cdhooper/mx29f1615_programmer/photos/2021_08_17_mx29f1615_programmer_rev6.jpg

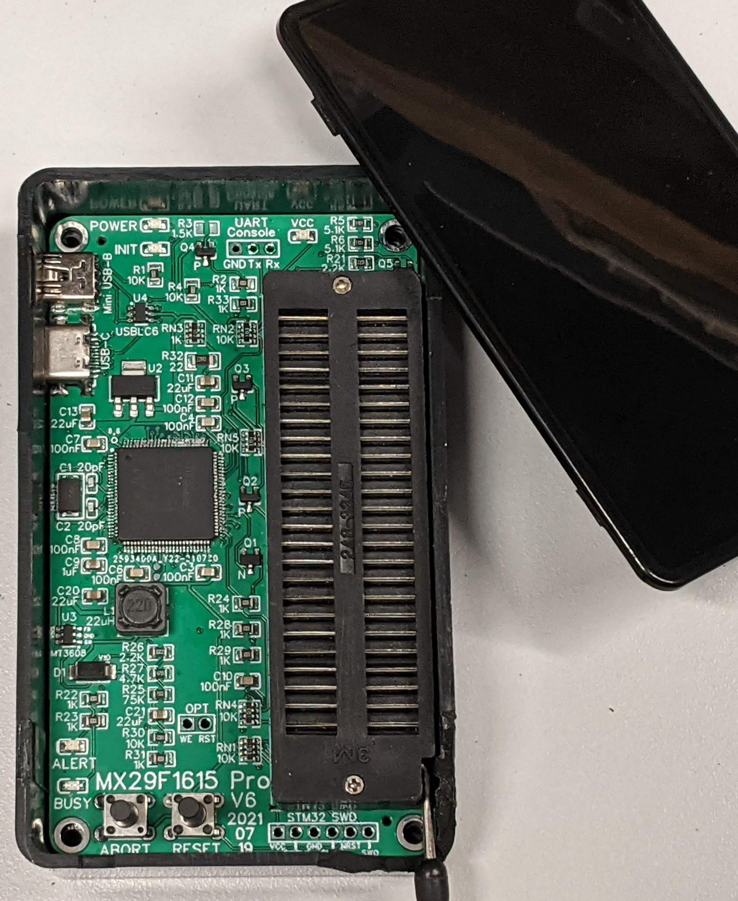
photos/2021_08_17_mx29f1615_programmer_rev6.jpg
