cdhooper/mx29f1615_programmer/photos/2021_01_05_mx29f1615_programmer_rev1_a.jpg

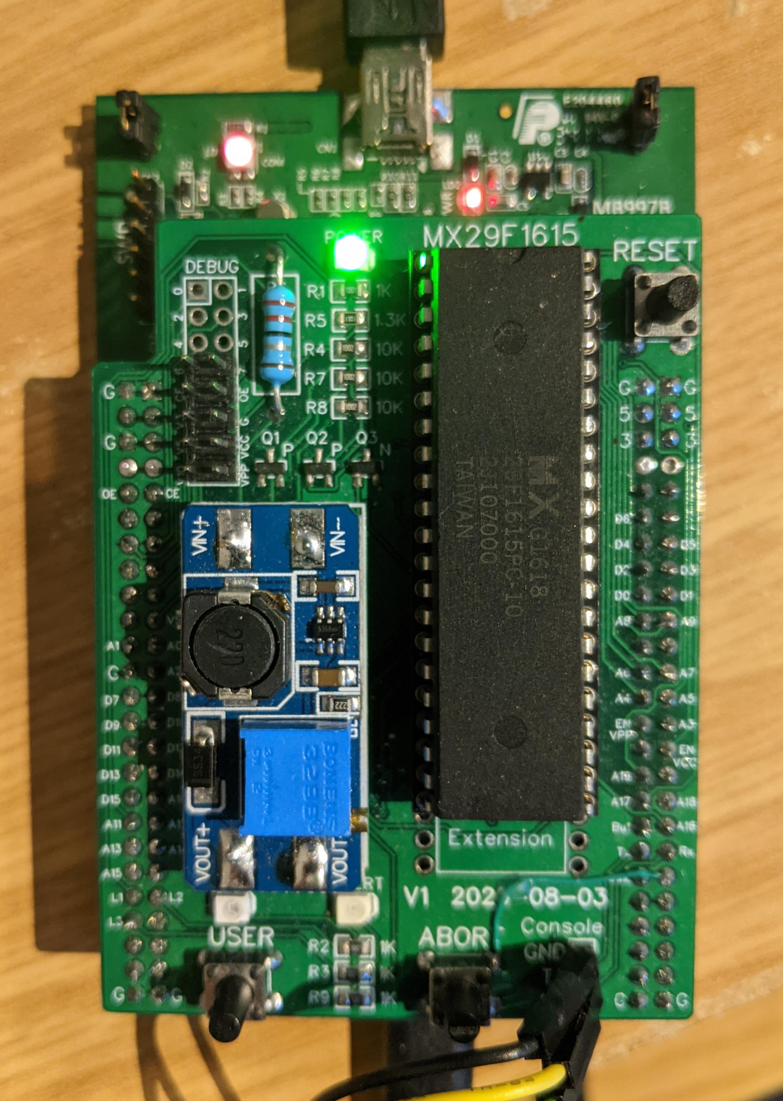
photos/2021_01_05_mx29f1615_programmer_rev1_a.jpg
