cdhooper/mx29f1615_programmer/photos/2021_04_21_mx29f1615_programmer_rev4_in_case_2.jpg

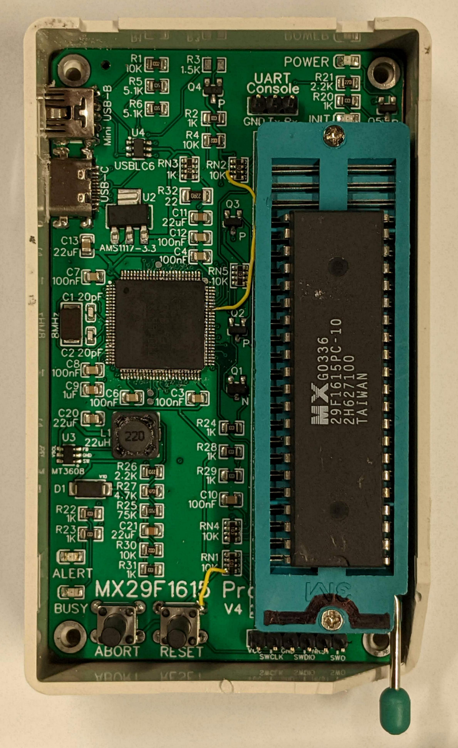
photos/2021_04_21_mx29f1615_programmer_rev4_in_case_2.jpg
