cdhooper/mx29f1615_programmer/photos/2021_06_29_mx29f1615_programmer_rev5.jpg

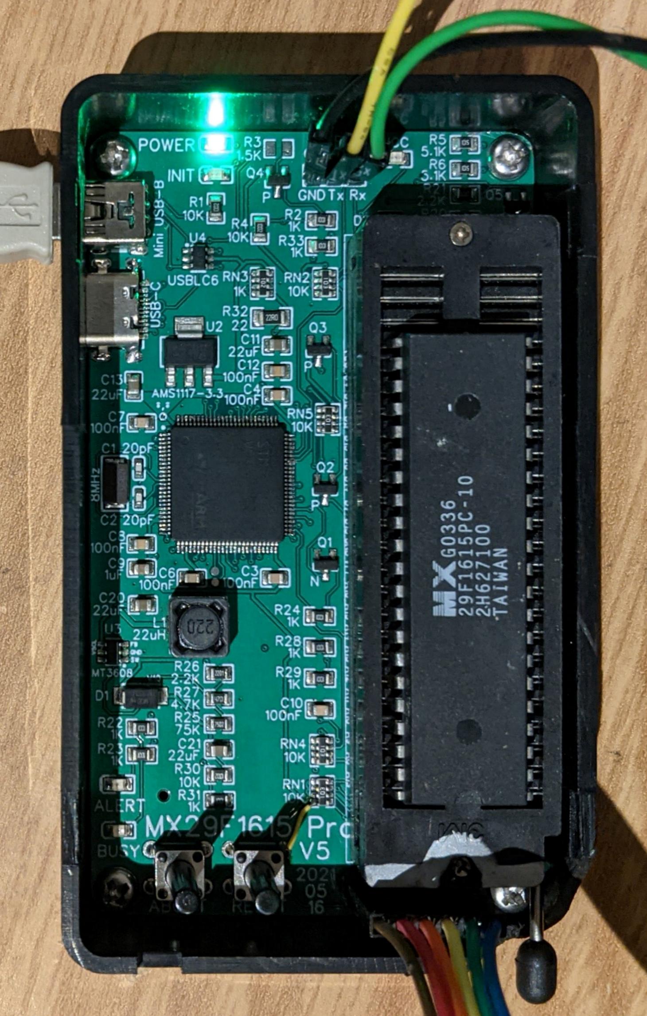
photos/2021_06_29_mx29f1615_programmer_rev5.jpg
