cdhooper/mx29f1615_programmer/rev6/photo_view_bottom.jpg

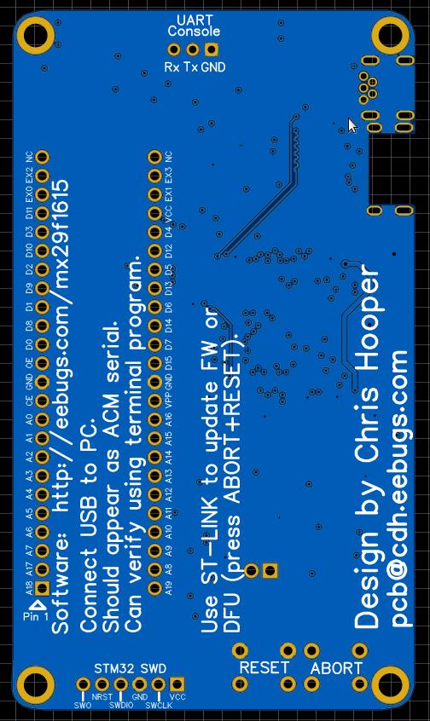
rev6/photo_view_bottom.jpg
