cdhooper/mx29f1615_programmer/rev6/BOM_PCB for case_2021-07-19.csv

ID | Name | Designator | Footprint | Quantity | Manufacturer Part | Manufacturer | Supplier | Supplier Part | Price | LCSC Assembly | JLCPCB Part Class
1 | OPT | H4 | HDR-2X1/2.54 | 1 | Z-211-0211-0021-001 | ZHENGLING | LCSC | C152154
2 | SS34_C8678 | D1 | DO-214AC_L4.3-W2.7-LS5.3-RD | 1 | SS34 | MDD | LCSC | C8678 |  | Yes
3 | SM4007PL | D2 | SOD-123F_L2.8-W1.8-LS3.7-RD | 1 | SM4007PL | MDD | LCSC | C64898 |  | Yes
4 | 8MHz | X1 | OSC-SMD_L5.0-W3.2 | 1 | X50328MSB2GI | YXC | LCSC | C115962 |  | Yes
5 | INIT | LED1-Y | LED0805-RD | 1 | 17-21SUYC/TR8 | KENTO | LCSC | C2296 |  | Yes
6 | POWER | LED2-G | LED0805-RD | 1 | 0805G (Green) | KENTO | LCSC | C2297 |  | Yes
7 | BUSY | LED3-Y | LED0805-RD | 1 | 17-21SUYC/TR8 | KENTO | LCSC | C2296 |  | Yes
8 | ALERT | LED4-R | LED-0805 | 1 | FC-2012HRK-620D | NATIONSTAR | LCSC | C84256 |  | Yes
9 | VCC | LED5-Y | LED0805-RD | 1 | 17-21SUYC/TR8 | KENTO | LCSC | C2296 |  | Yes
10 | MX29F1615-ZIF48 | U5 | DIP-48_W15.24MM_ZIF | 1
11 | 10K | RN1,RN2,RN4,RN5 | RES-ARRAY-SMD_0603-8P-L3.2-W1.6-BL | 4 | 4D03WGJ0103T5E | UniOhm | LCSC | C29718 |  | Yes
12 | 1K | RN3 | RES-ARRAY-SMD_0603-8P-L3.2-W1.6-BL | 1 | 4D03WGJ0102T5E | UniOhm | LCSC | C20197 |  | Yes
13 | STM32F107VCT6 | U1 | LQFP-100_L14.0-W14.0-P0.50-LS16.0-BL | 1 | STM32F107VCT6 | STMicroelectronics | LCSC | C8315 |  | Yes
14 | 5.1K | R5,R6 | R0805 | 2 | 0805W8F5101T5E | UniOhm | LCSC | C27834 |  | Yes
15 | 1K | R33,R24,R28,R29,R31 | 0805 | 5 | 0805W8F1001T5E | UniOhm | LCSC | C17513 |  | Yes
16 | MT3608 | U3 | SOT-23-6_L2.9-W1.6-P0.95-LS2.8-BR | 1 | MT3608 | AEROSEMI | LCSC | C84817 |  | Yes
17 | USBLC6 | U4 | SOT-23-6_L2.9-W1.6-P0.95-LS2.8-BR | 1 | USBLC6-2SC6 | STMicroelectronics | LCSC | C7519 |  | Yes
18 | Mini USB-B | USB1 | MINI-USB-TH_USB-MINI-2 | 1 | MINI 5PFemale90Degree plate four feet copper shell LCPVinyl | ValuePro | LCSC | C46398
19 | Console | H2 | HDR-TH_3P-P2.54-V-S2.54 | 1 | 5-146280-3 | TE Connectivity | LCSC | C306138
20 | STM32 SWD | H3 | HDR-6X1/2.54 | 1 | Female header 1*6p | BOOMELE | LCSC | C40877
21 | 10K | R4 | R0805 | 1 | 0805W8F1002T5E | UniOhm | LCSC | C17414 |  | Yes
22 | 75K | R25 | R0805 | 1 | 0805W8F7502T5E | UniOhm | LCSC | C17819 |  | Yes
23 | 2.2K | R26 | R0805 | 1 | 0805W8F2201T5E | UniOhm | LCSC | C17520 |  | Yes
24 | 4.7K | R27 | R0805 | 1 | 0805W8F4701T5E | UniOhm | LCSC | C17673 |  | Yes
25 | 10K | R30 | R0805 | 1 | 0805W8F1002T5E | UniOhm | LCSC | C17414 |  | Yes
26 | 22 | R32 | R1206 | 1 | 1206W4F220JT5E | UniOhm | LCSC | C17958 |  | Yes
27 | BSS84 | Q3,Q2,Q5 | SOT-23(SOT-23-3) | 3 | LBSS84LT1G | LRC | LCSC | C8492 |  | Yes
28 | AO3400A | Q1 | SOT-23-3_L2.9-W1.6-P1.90-LS2.8-BR | 1 | AO3400A | AOS | LCSC | C20917 |  | Yes
29 | 1K | R20,R22,R23 | 0805 | 3 | 0805W8F1001T5E | UniOhm | LCSC | C17513 |  | Yes
30 | PB0 | B0 | TEST_POINT_SMD_1MM | 1
31 | PB1 | B1 | TEST_POINT_SMD_1MM | 1
32 | 10K | R1 | R0805 | 1 | 0805W8F1002T5E | UniOhm | LCSC | C17414 |  | Yes
33 | 100nF | C10,C12,C4,C3,C6,C8,C7 | C0805 | 7 | CC0805KRX7R9BB104 | YAGEO | LCSC | C49678 |  | Yes
34 | Mounting_Hole | MK4,MK3,MK2,MK1 | MOUNTING HOLE | 4 | ?
35 | 22uF | C11,C13,C20,C21 | C0805 | 4 | CL21A226MAQNNNE | SAMSUNG | LCSC | C45783 |  | Yes
36 | ABORT | BUTTON1 | KEY-6.0*6.0-2 | 1 | 6x6x15Plastic head | ReliaPro | LCSC | C10891
37 | 20pF | C2,C1 | C0603 | 2 | CL10C200JB8NNNC | SAMSUNG | LCSC | C1648 |  | Yes
38 | 1uF | C9 | C0805 | 1 | CL21B105KBFNNNE | SAMSUNG | LCSC | C28323 |  | Yes
39 | AMS1117-3.3 | U2 | SOT-223-3_L6.5-W3.4-P2.30-LS7.0-BR | 1 | AMS1117-3.3 | AMS | LCSC | C6186 |  | Yes
40 | RESET | BUTTON2 | KEY-6.0*6.0-2 | 1 | 6x6x15Plastic head | ReliaPro | LCSC | C10891
41 | 1K | R2 | 0805 | 1 | 0805W8F1001T5E | UniOhm | LCSC | C17513 |  | Yes
42 | BSS84 | Q4 | SOT-23(SOT-23-3) | 1 | LBSS84LT1G | LRC | LCSC | C8492 |  | Yes
43 | 2.2K | R21 | R0805 | 1 | 0805W8F2201T5E | UniOhm | LCSC | C17520 |  | Yes
44 | 22uH | L1 | IND-SMD_L7.0-W6.8 | 1 | SMRH74-220MT | SXN | LCSC | C27442
45 | TYPE-C 3.1-16P_C168689 | USBC1 | USB-C-SMD_TYPE-C-USB-12 | 1 | TYPE-C 3.1-16P_C168689 | LCSC | LCSC | C168689 |  |  | Extended Part
