cdhooper/mx29f1615_programmer/(threads)

Thread 1 (2022-06-04):

Noob question!

f-bone, 2022-06-04:
apologies for the probably stupid question.

I have a few fake blue-pills I bought on AliExpress to use with the Greaseweazle project (https://github.com/keirf/greaseweazle) but they don't pass the blinky test. Can I use them with your project as my TL866II programmer can't seem to program 29f1615s? (it can read all 4 banks using the 16bit adapter and jumpers but programming *almost* always fails).

thank you!
br,
george

cdhooper, 2022-06-04:
Hello George,
I've also got a TL866II programmer and also wasn't successful programming the MX29F1615 parts, even after modifying the Linux minipro utility.
Unfortunately you can't use the blue pill boards with this project. Although the Blue Pill does use an STM32F103 (or mostly compatible) CPU, it uses the 48-pin version of the part. This project requires the 100-pin version. You'd need one of these: STM32F105VCT6 (preferred), STM32F107VCT6, or STM32F103VCT6. Because of the chip shortage, these parts have all gotten much more expensive over the past year, to the point they are going for about 5x what they should be!

f-bone, 2022-06-04:
Thank you for your time and detailed explanation!

Closed 2022-06-04.

Thread 2 (2023-08-30):

Software

thbreidenbach, 2023-08-30:
Hi, successfully running the programmer on several Pi and windows via wsl2. For usability it might come in handy to introduce a new switch to select banks in a more verbose way. e.g. `mxprog - b 1 -w xy.bin` for programming bank 1. A gui would be great too, maybe we could come up with a simple web gui.

Are you okay with group buys? Couldn't find licensing info so over at a1k I started an Info thread on the programmer including the link to the git and ordered a test run of ten of which I initially gave 4 to different testers.
I had no issues myself but for the rest we would likely distribute a vmware linux image with precompiled binaries alongsides the programmer.

Thanks for the great work!

Best,

Thorsten

cdhooper, 2023-08-31:
Hello Thorsten, I appreciate you reaching out and asking. A new -b option for the bank number would be great. For a write or verify, it could compute the written address based on a multiple of the detected input file size. For a read, it could be a multiple of the read length. I'll see what I can do to make this happen.

Regarding a GUI, I'd be fine with someone else implementing a wrapper around mxprog or reusing mxprog source to do this, and would happily take that in a Pull request.

I am okay with group buys. and am perfectly fine with builders making a nominal profit. There is a minimal page which does give some minimal information on how to load firmware on the programmer and command line usage for mxprog: http://eebugs.com/mx29f1615/

I will leave this issue report open until the new "-b" option is committed.

cdhooper, 2023-09-14:
Added -b option to mxprog so that a bank for programming may be specified.
