cdhooper/mx29f1615_programmer/rev6/PCB_bot for case_2021-07-19.pdf

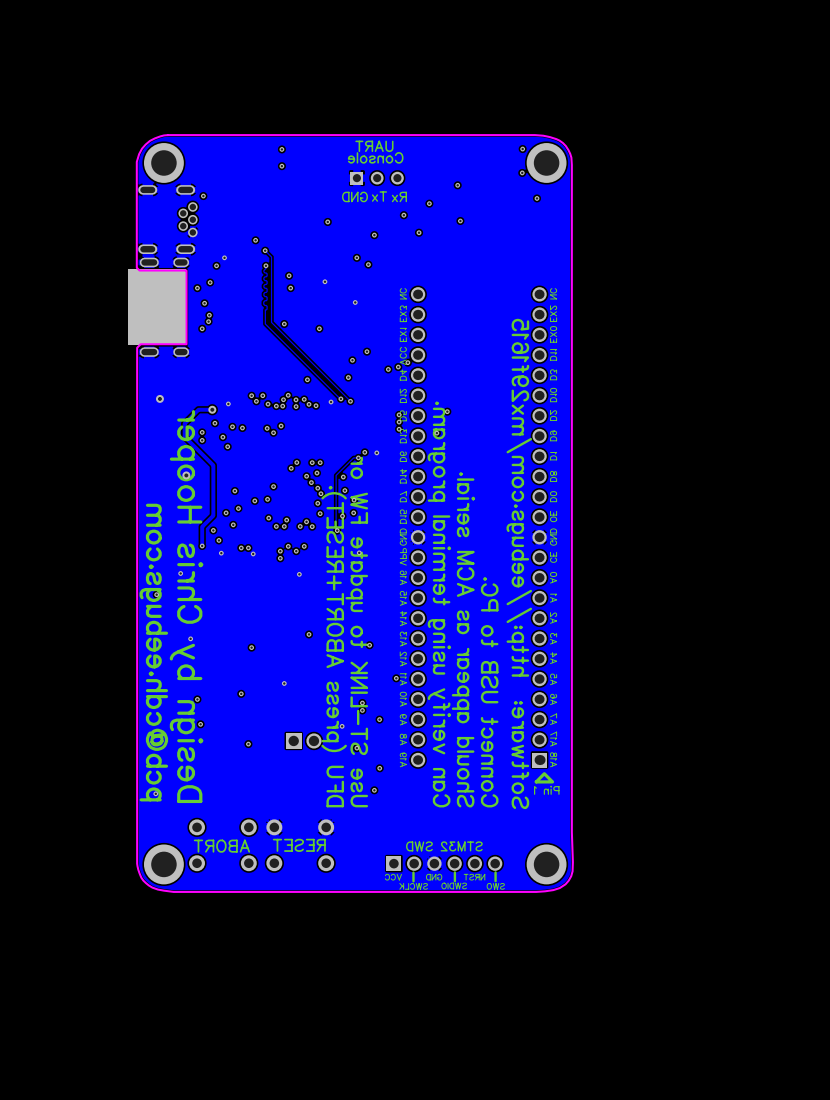
[picture p13: page 1]
