cdhooper/mx29f1615_programmer/rev6/PCB_bot for case_2021-07-19_mirror.pdf

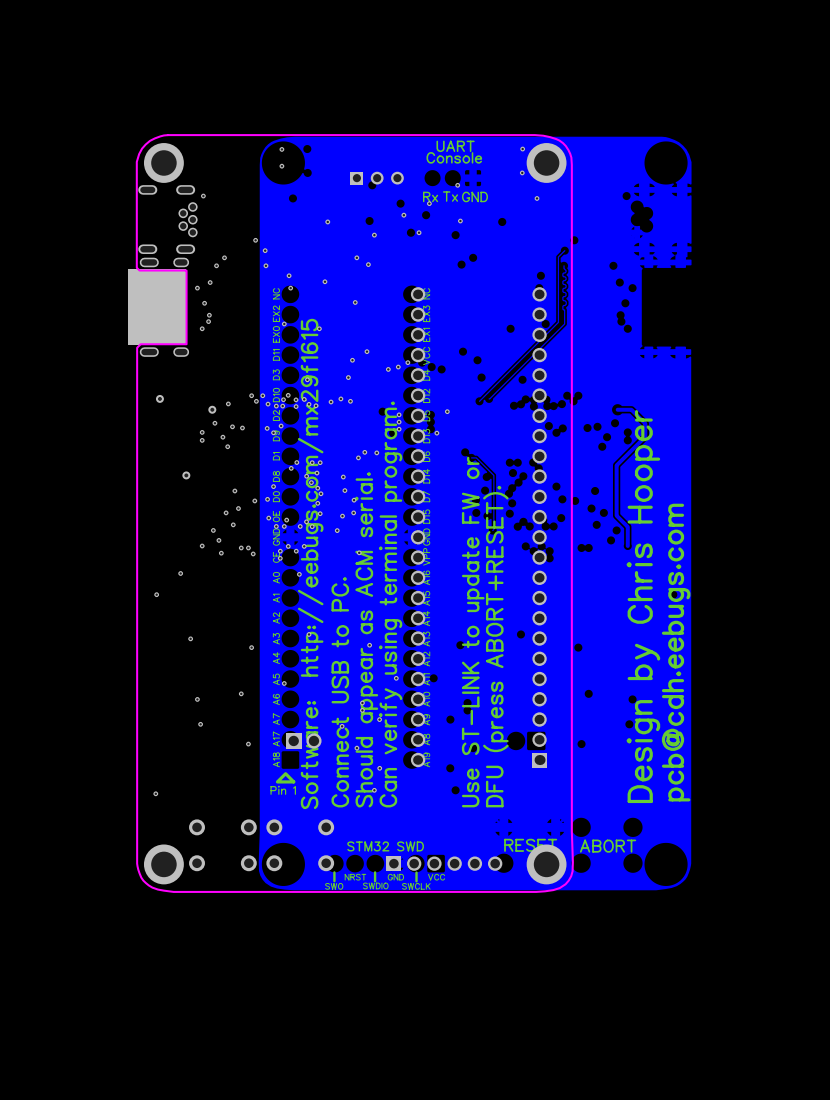
[picture p14: page 1]
