cdhooper/mx29f1615_programmer/rev6/PCB_top for case_2021-07-19.pdf

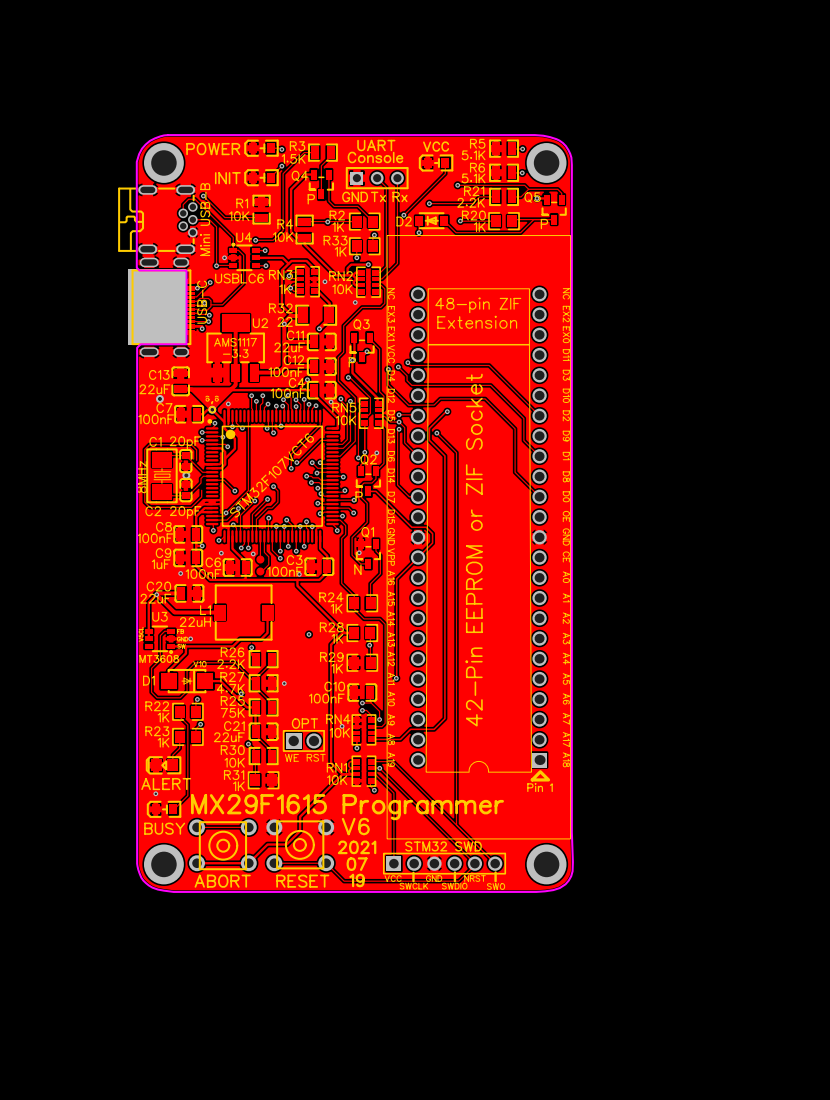
[picture p15: page 1]
