cdhooper/mx29f1615_programmer/rev5/Schematic_MX29F1615 Programmer_2021-05-16.pdf

A | A
B | B

# MX29F1615 Programmer

An STM32 Cortex-M3 CPU (STM32F107VCT6) is used to provide a programmer interface between a PC and the Macronix MX29F1615 EEPROM part. The implementation is a combination of custom hardware, firmware, and Linux software to achieve easy erasure, programming, and verification of MX29F1615 EEPROM parts. The Linux software could be ported to MacOS or Windows, as it mostly just requires
a working USB ACM driver to communicate with the firmware running on the STM32.
The major hardware components consist of the STM32 (256KB integrated flash and 48K integrated SRAM), a USB connector, three status LEDs, three buttons, a 3.3V power supply, and a 10V power supply (both fed by USB 5V power), and finally a socket with holes large enough to accommodate a commonly available 48-pin ZIF socket. Note that the MX29F1615 is a 42-pin device, so you may choose to install
a cheaper 42-pin socket instead.

# Rev 5 - 2021-05-16 Socket

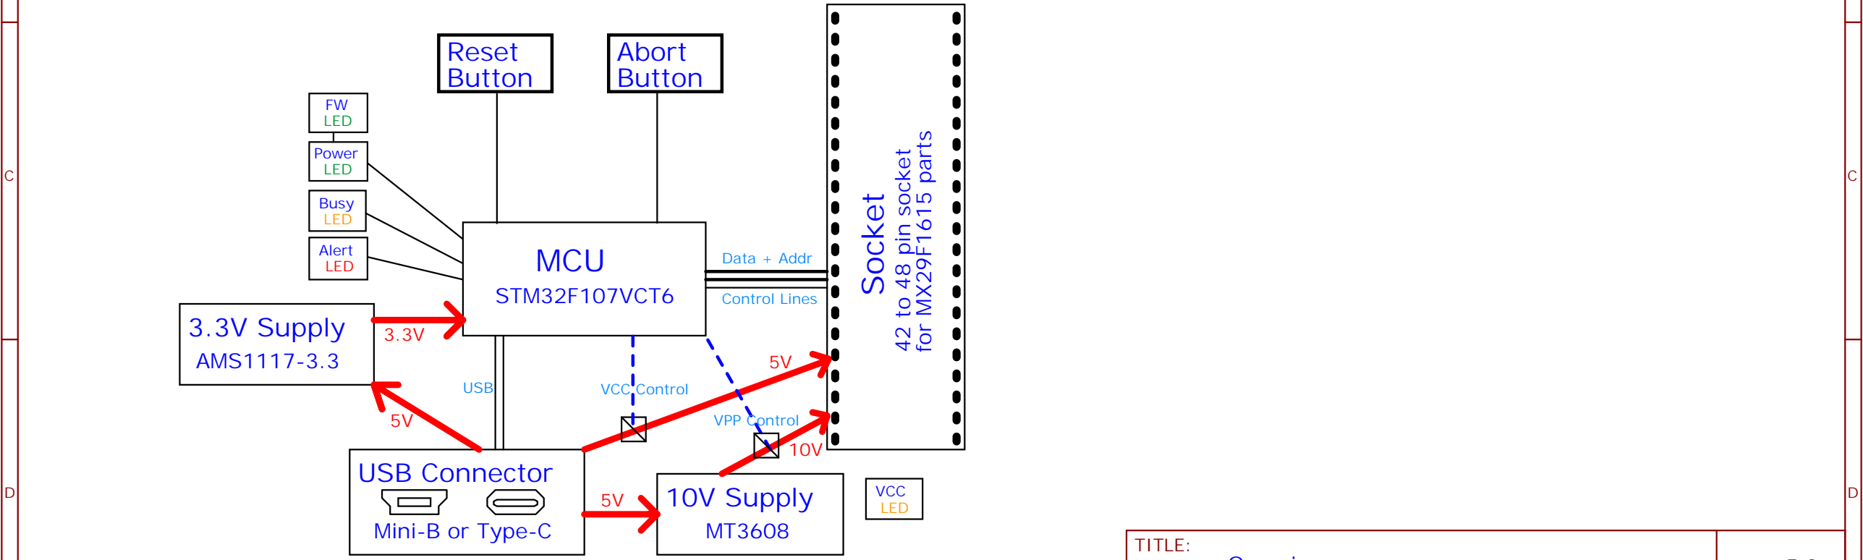
[picture p16: figure]
TITLE:; STM32F107VCT6; MCU; Reset Button; Abort Button; 3.3V Supply AMS1117-3.3; 10V Supply; 42 to 48 pin socket; for MX29F1615 parts; USB Connector; Mini-B or Type-C; VPP Control; VCC Control; Data + Addr; Control Lines; LED; Power; Busy; Alert; FW LED; USB; VCC LED
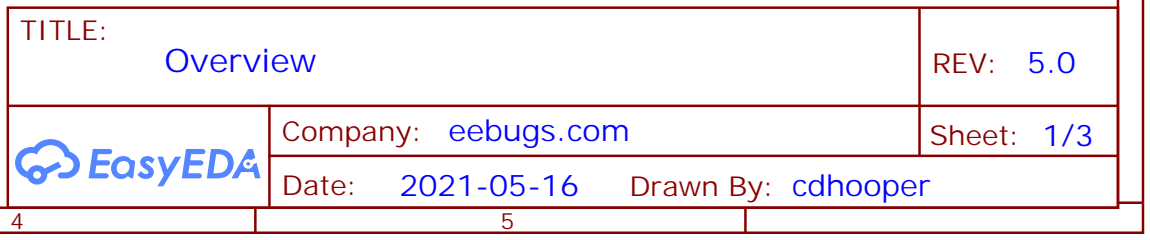
[picture p17: figure]
Overview; REV: 5.0; Date:; Sheet: 1/3 Drawn By: cdhooper; Company: eebugs.com

# Power

# STM32F107VCT6

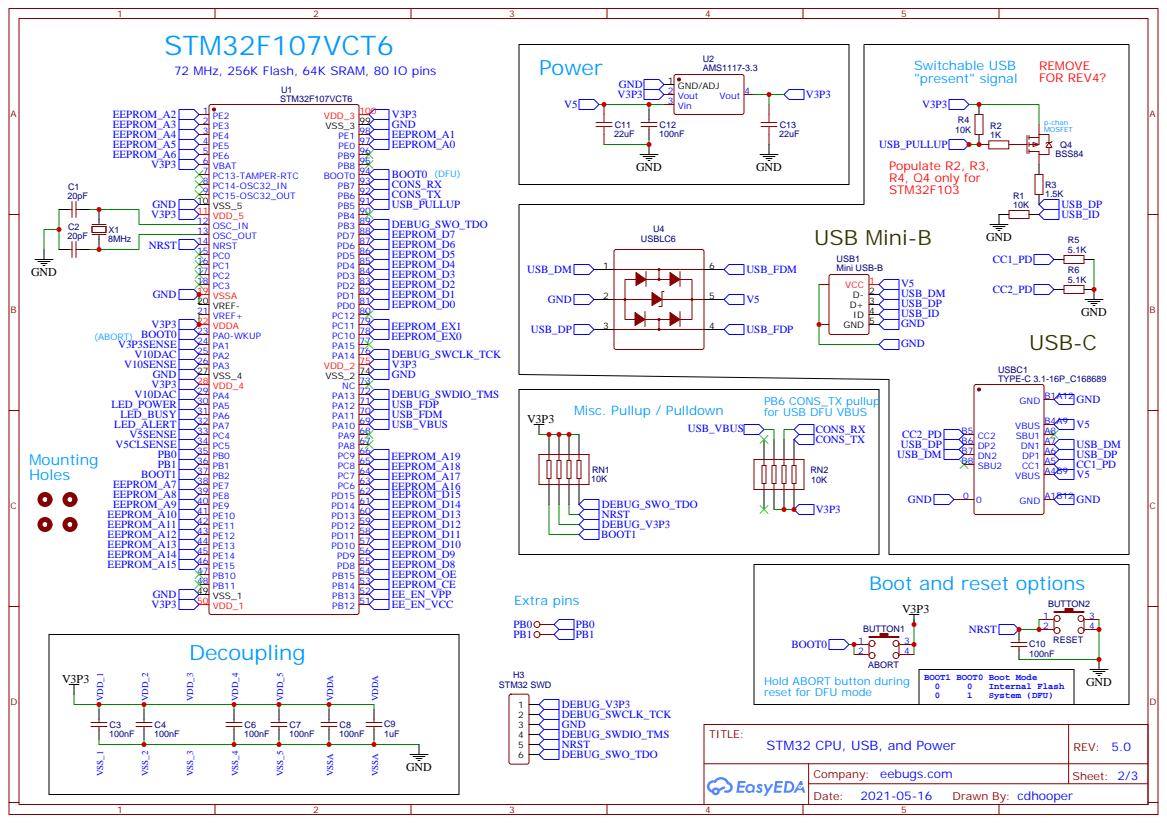
[picture p18: page 2]

72 MHz, 256K Flash, 64K SRAM, 80 IO pins

PB6 CONS_TX pullup
for USB DFU VBUS

Boot and reset options

Hold ABORT button during
reset for DFU mode

# MX29F1615 Programming Header (ZIF-48 socket compatible)

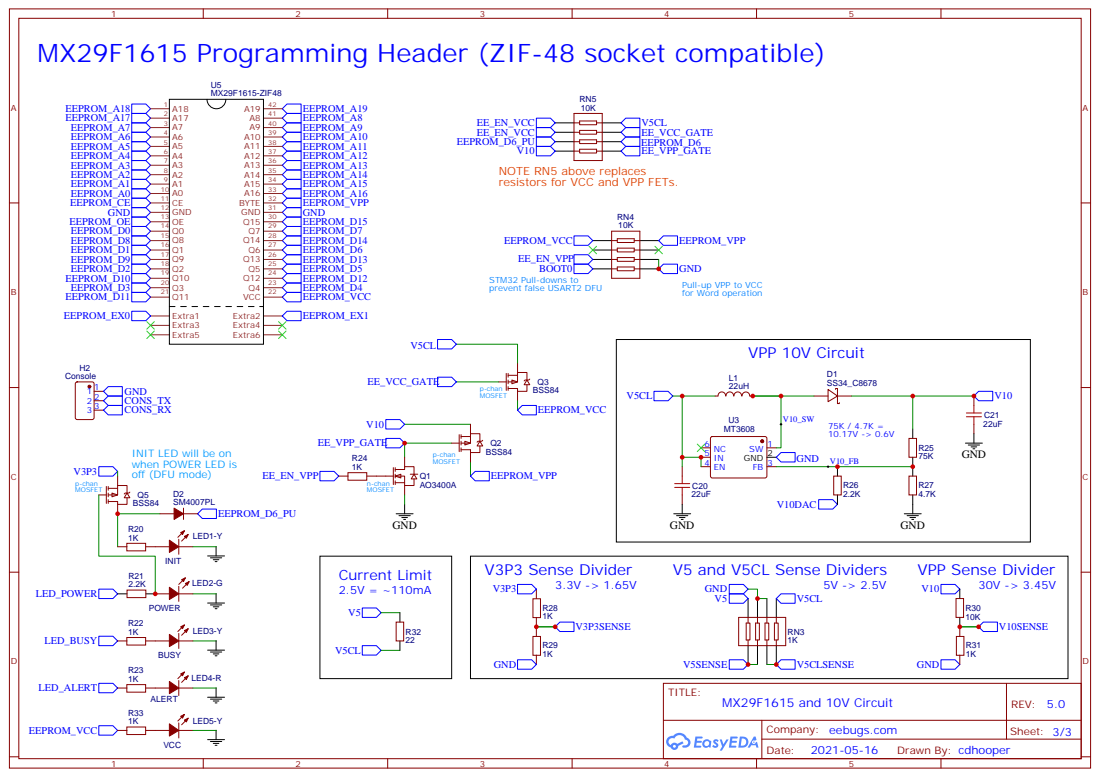
[picture p19: page 3]

NOTE RN5 above replaces
resistors for VCC and VPP FETs.

GND
Pull-up VPP to VCC
for Word operation

INIT LED will be on
when POWER LED is
off (DFU mode)
