cdhooper/mx29f1615_programmer/rev5/PCB_2021-05-16_bottom.pdf

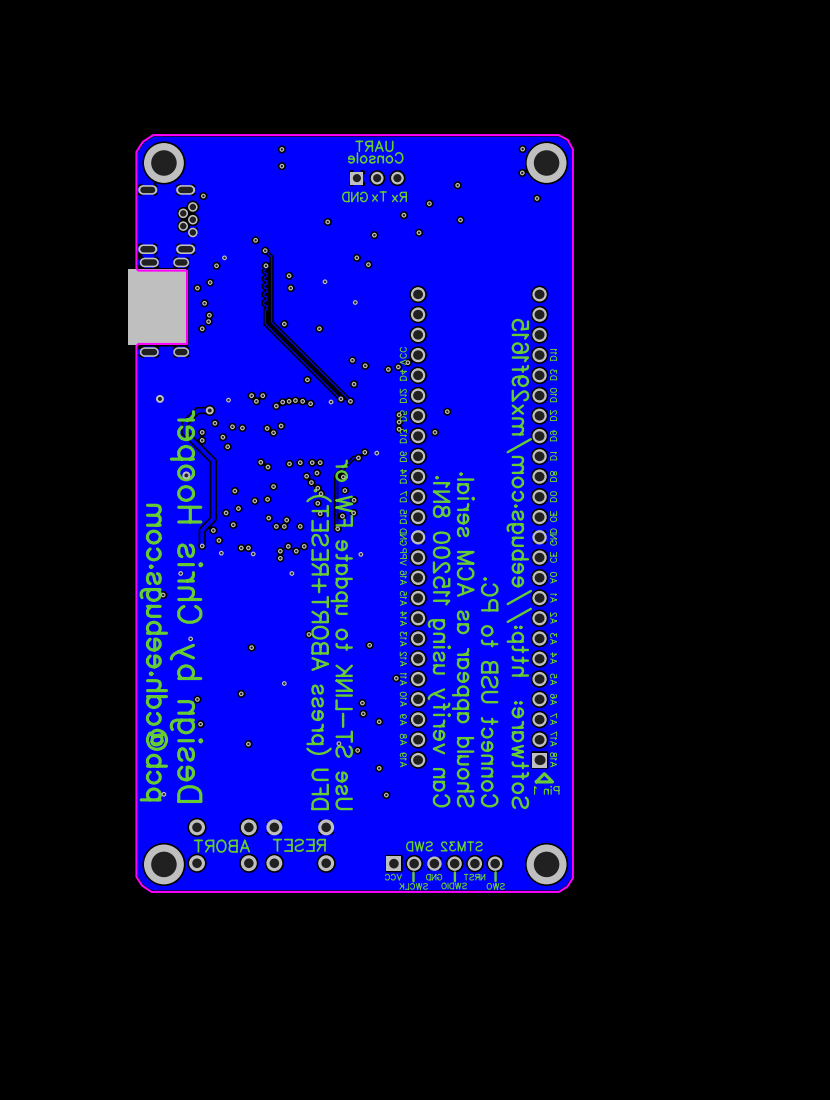
[picture p24: page 1]
