cdhooper/mx29f1615_programmer/rev5/PCB_2021-05-16_bottom_mirror.pdf

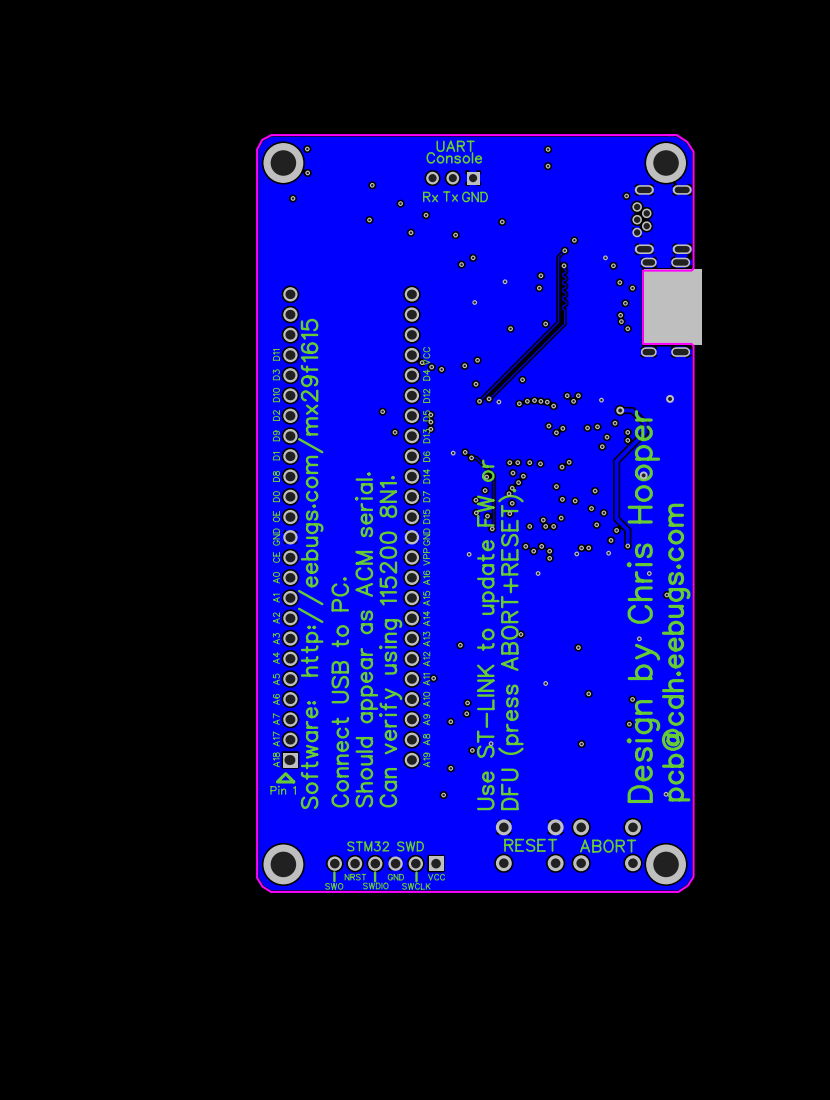
[picture p25: page 1]
