cdhooper/mx29f1615_programmer/rev5/PCB_2021-05-16_top.pdf

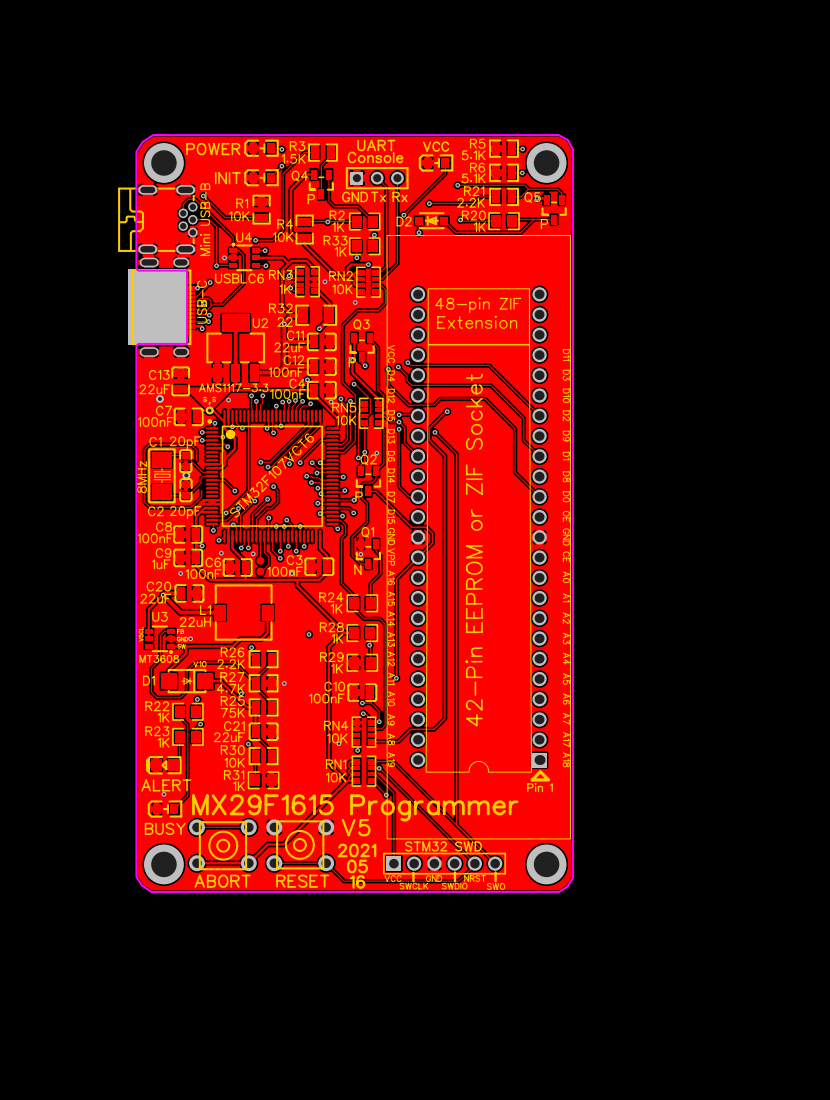
[picture p26: page 1]
