cdhooper/mx29f1615_programmer/rev4/PCB_bot for case_2021-03-23.pdf

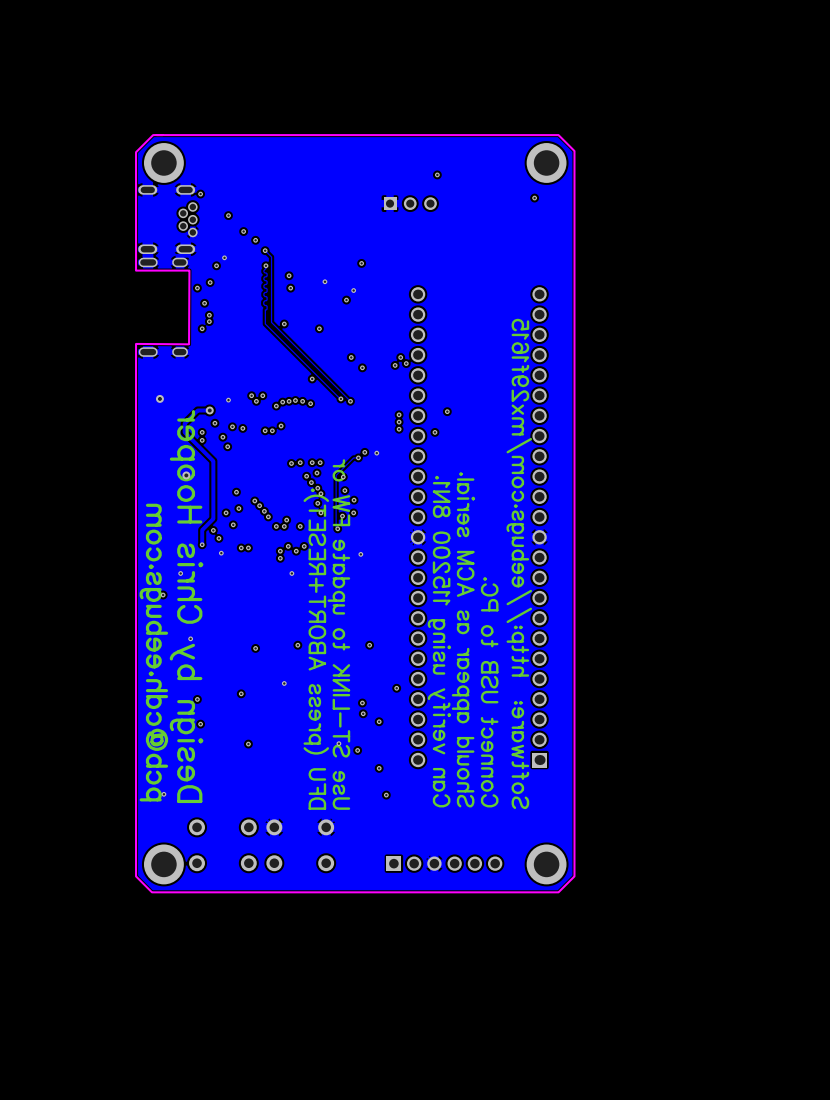
[picture p27: page 1]
