cdhooper/mx29f1615_programmer/rev4/PCB_bot for case_2021-03-23_mirror.pdf

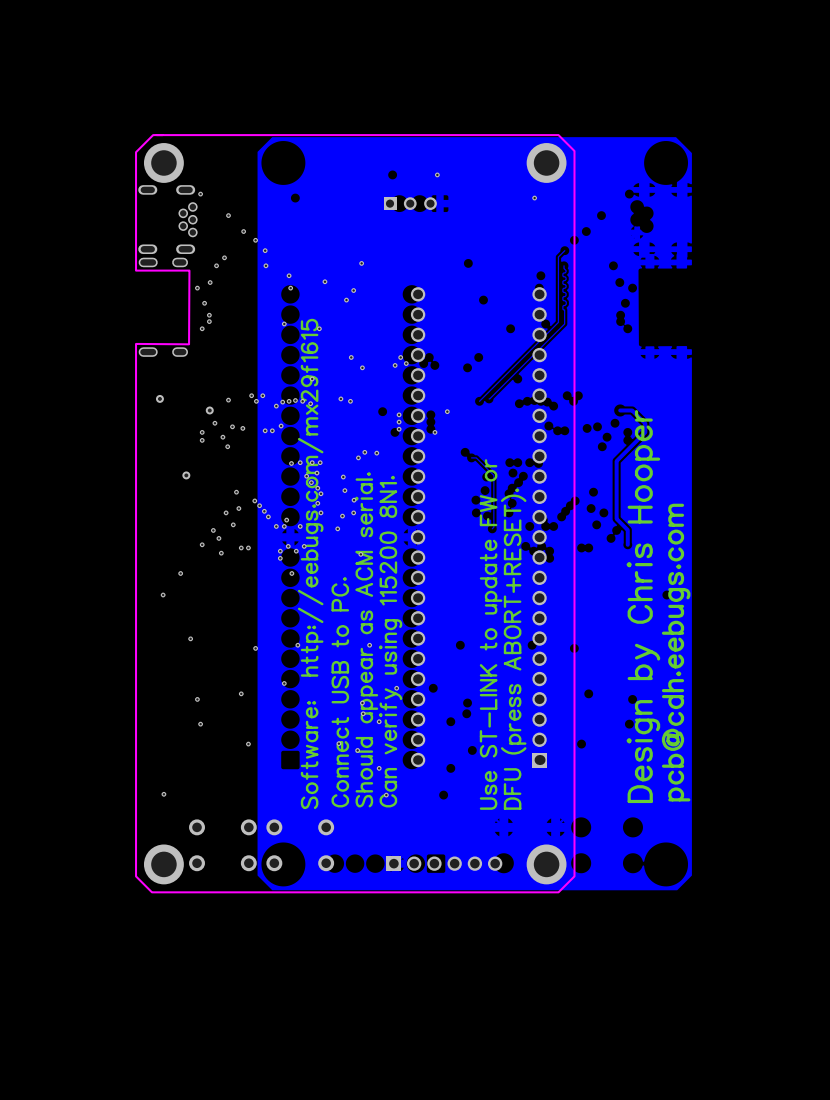
[picture p28: page 1]
