cdhooper/mx29f1615_programmer/rev4/PCB_top for case_2021-03-23.pdf

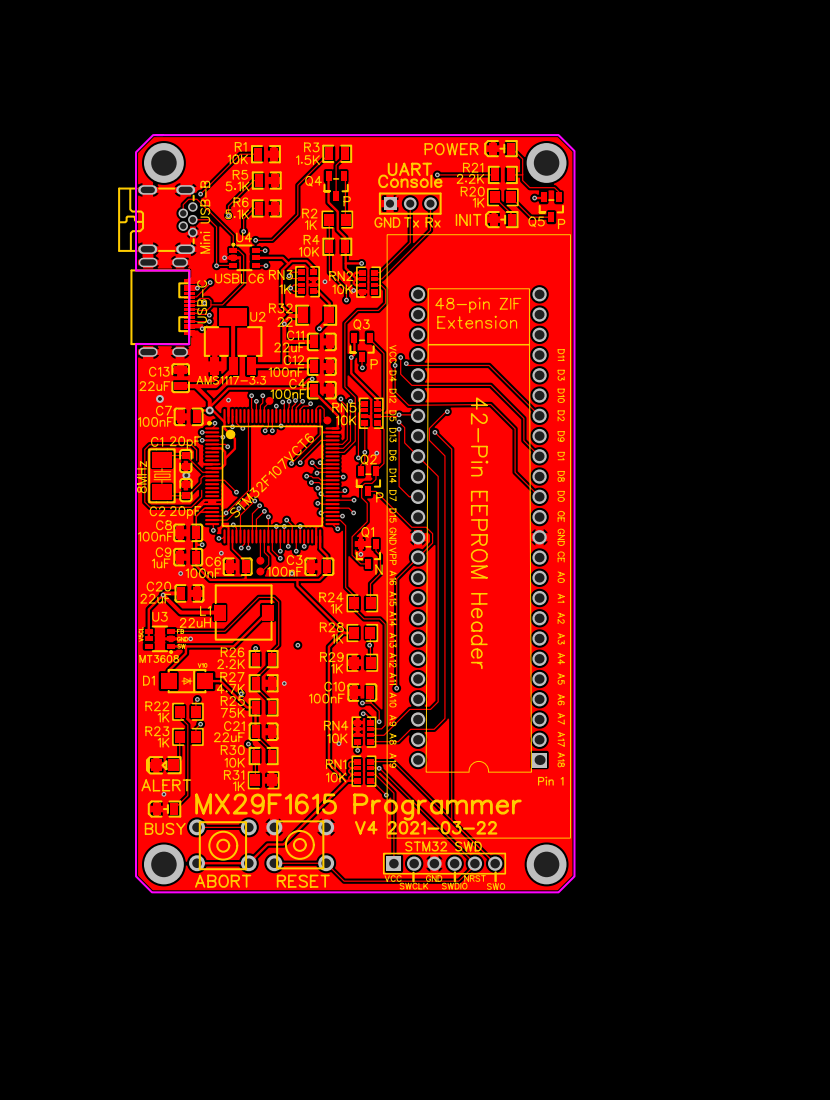
[picture p29: page 1]
