cdhooper/mx29f1615_programmer/fw/fwf103/fwf103.ioc

PD12.GPIO_Label=D12
PB14.GPIO_Label=CE
PC6.GPIO_Label=A16
PA6.GPIO_Label=LED_BUSY
PB13.Signal=GPIO_Output
PD6.GPIO_Label=D6
PE6.GPIO_Label=A6
PD4.Signal=GPIO_Input
PC7.Signal=GPIO_Input
PD0.Signal=GPIO_Input
PD8.Signal=GPIO_Input
PE5.Signal=GPIO_Input
PE1.Signal=GPIO_Input
PD1.GPIO_Label=D1
PB12.GPIO_Label=EE_EN_VCC
PC4.GPIO_Label=V5SENSE
PE9.Signal=GPIO_Input
PE4.GPIO_Label=A4
PE2.Signal=GPIO_Input
PE10.Signal=GPIO_Input
PD12.Signal=GPIO_Input
PA10.Signal=USART1_RX
PE12.GPIO_Label=A12
PE10.GPIO_Label=A10
PA4.GPIO_Label=V10FBDAC
PD15.Signal=GPIO_Input
PD9.GPIO_Label=D9
PA9.GPIO_Label=CONS_TX
PD3.Signal=GPIO_Input
PC6.Signal=GPIO_Input
PB11.GPIO_Label=EE_OPT_RST
PD7.Signal=GPIO_Input
PD1.Signal=GPIO_Input
PC0.Signal=GPIO_Output
PA0-WKUP.GPIO_Label=BUTTON1
PA0-WKUP.Signal=GPIO_Input
PD10.Signal=GPIO_Input
PE8.GPIO_Label=A8
PA9.Signal=USART1_TX
PE9.GPIO_Label=A9
PB10.Signal=GPIO_Input
PB14.Signal=GPIO_Input
PA5.Signal=GPIO_Output
PE1.GPIO_Label=A1
PE14.Signal=GPIO_Input
PE15.Signal=GPIO_Input
PB15.GPIO_Label=OE
PE8.Signal=GPIO_Input
PA1.GPIO_Label=V3P3SENSE
PC7.GPIO_Label=A17
PA4.Signal=COMP_DAC1_group
PB5.Signal=GPIO_Output
PE13.GPIO_Label=A13
PA5.GPIO_Label=LED_POWER
PD11.Signal=GPIO_Input
PE5.GPIO_Label=A5
PA11.Signal=USB_DM
PE3.Signal=GPIO_Input
PD2.Signal=GPIO_Input
PD2.GPIO_Label=D2
Mcu.UserName=STM32F103VCTx
PE11.GPIO_Label=A11
PC0.GPIO_Label=CLKBND
PD0.GPIO_Label=D0
PB13.GPIO_Label=EE_EN_VPP
PB11.Signal=GPIO_Input
PB15.Signal=GPIO_Input
PD13.Signal=GPIO_Input
PA12.Signal=USB_DP
PD11.GPIO_Label=D11
PE13.Signal=GPIO_Input
PA10.GPIO_Label=CONS_RX
PE4.Signal=GPIO_Input
PD7.GPIO_Label=D7
PD13.GPIO_Label=D13
PA6.Signal=GPIO_Output
PD5.GPIO_Label=D5
PA2.GPIO_Label=V10FBSENSE
PA15.Signal=SYS_JTDI
PE0.GPIO_Label=A0
PB5.GPIO_Label=USB_PULLUP
PC5.Signal=ADCx_IN15
PD3.GPIO_Label=D3
PE7.Signal=GPIO_Input
PD6.Signal=GPIO_Input
PE2.GPIO_Label=A2
PB4.Signal=SYS_NJTRST
PA3.Signal=ADCx_IN3
PD15.GPIO_Label=D15
PC9.GPIO_Label=A19
PC8.Signal=GPIO_Input
PC4.Signal=ADCx_IN14
PE14.GPIO_Label=A14
PD9.Signal=GPIO_Input
PD5.Signal=GPIO_Input
PD8.GPIO_Label=D8
PC8.GPIO_Label=A18
PA13.Signal=SYS_JTMS-SWDIO
PE15.GPIO_Label=A15
PB10.GPIO_Label=EE_OPT_WE
PD10.GPIO_Label=D10
PE11.Signal=GPIO_Input
PA1.Signal=ADCx_IN1
PD4.GPIO_Label=D4
PD14.GPIO_Label=D14
PE6.Signal=GPIO_Input
PE0.Signal=GPIO_Input
PE7.GPIO_Label=A7
PE12.Signal=GPIO_Input
PA2.Signal=ADCx_IN2
PD14.Signal=GPIO_Input
PB3.Signal=SYS_JTDO-TRACESWO
PA7.GPIO_Label=LED_ALERT
PC5.GPIO_Label=V5CLSENSE
PA14.Signal=SYS_JTCK-SWCLK
PE3.GPIO_Label=A3
PC9.Signal=GPIO_Input
PB12.Signal=GPIO_Output
PA3.GPIO_Label=V10SENSE
PA7.Signal=GPIO_Output
