cdhooper/mx29f1615_programmer/fw/adc.c

/*
 * This is free and unencumbered software released into the public domain.
 * See the LICENSE file for additional details.
 *
 * Designed by Chris Hooper in 2020.
 *
 * ---------------------------------------------------------------------
 *
 * Analog to digital conversion for sensors.
 */

#include <stdlib.h>
#include <stdbool.h>
#include <string.h>
#include "board.h"
#include "cmdline.h"
#include "printf.h"
#include "main.h"
#include "prom_access.h"
#include "adc.h"
#include "timer.h"

#define TEMP_BASE          25000     // Base temperature is 25C

#if defined(STM32F407xx)
#define TEMP_V25           760       // 0.76V
#define TEMP_AVGSLOPE      25        // 2.5
#define SCALE_VREF         12100000  // 1.21V
#define V10_DIVIDER_SCALE  3 / 3450  // Rev 1 divider: (10k/1.33k  1.174V=10V)

#elif defined (STM32F1)
/* Verified STM32F103xE and STM32F107xC are identical */
#define TEMP_V25           1410      // 1.34V-1.52V; 1.41V seems more accurate
#define TEMP_AVGSLOPE      43        // 4.3
#define SCALE_VREF         12000000  // 1.20V
#define V10_DIVIDER_SCALE  1 / 909   // Rev 2+ divider: (10k/1k  0.909V=10V)

#else
#error STM32 architecture temp sensor slopes must be known
#endif

#define V5_EXPECTED_MV     5000      // 5V expressed as millivolts
#define V10_EXPECTED_MV    10000     // 10V expressed as millivolts
#define V3P3_DIVIDER_SCALE 2 / 10000 // (1k / 1k)
#define V5_DIVIDER_SCALE   2 / 10000 // (1k / 1k)
#define V5CL_DIVIDER_SCALE 2 / 10000 // (1k / 1k)

#ifdef USE_HAL_DRIVER
/* ST-Micro HAL Library compatibility definitions */
#define ADC_CCR(x) (x->CCR)
#define ADC_CR2(x) (x->CR2)
extern ADC_HandleTypeDef hadc1;

#ifndef STM32F4
extern DAC_HandleTypeDef hdac;
#endif

#define CHANNEL_COUNT 7

#else
/* libopencm3 */
#include <libopencm3/stm32/adc.h>
#include <libopencm3/stm32/dac.h>
#include <libopencm3/stm32/dma.h>
#include <libopencm3/stm32/rcc.h>
#include <libopencm3/stm32/gpio.h>
#if defined(STM32F407xx)
#define ADC_CHANNEL_TEMP ADC_CHANNEL_TEMP_F40
#endif

static const uint8_t channel_defs[] = {
    ADC_CHANNEL_VREF,  // 0: Vrefint (used to calibrate other readings
    ADC_CHANNEL_TEMP,  // 1: Vtemp Temperature sensor
#ifdef STM32F4  /* Rev1 */
    14,                // 2: PC4 - EEPROM V10 (10k/1.33k divider)
    ADC_CHANNEL_VBAT,  // 3: VBAT input  (50k/50k internal divider)
    11,                // 4: PC1 - NC
    15,                // 5: PC5 - NC
    2,                 // 6: PA2 - NC
#else /* STM32F1 */
    3,                 // 2: PA3 - EEPROM V10  (10k/1k divider)
    1,                 // 3: PA1 - V3P3        (1k/1k divider)
    14,                // 4: PC4 - V5          (1k/1k divider)
    15,                // 5: PC5 - EEPROM V5CL (1k/1k divider)
    2,                 // 6: PA2 - V10FB (V10 feedback for regulator)
#endif
};

typedef struct {
    uint32_t gpio_port;
    uint16_t gpio_pin;
} channel_gpio_t;
static const channel_gpio_t channel_gpios[] = {
#ifdef STM32F4
    { GPIOC, GPIO4 },  // PC4 - EEPROM V10
    { GPIOC, GPIO1 },  // PC1 - NC
    { GPIOC, GPIO5 },  // PC5 - NC
    { GPIOA, GPIO2 },  // PA2 - NC
#else
    { GPIOA, GPIO3 },  // PA3 - EEPROM V10
    { GPIOA, GPIO1 },  // PA1 - V3P3
    { GPIOC, GPIO4 },  // PC4 - V5
    { GPIOC, GPIO5 },  // PC5 - EEPROM V5CL
    { GPIOA, GPIO2 },  // PA2 - V10FB
#endif
};

#define CHANNEL_COUNT ARRAY_SIZE(channel_defs)
#endif  /* libopencm3 */

int v5_overcurrent = false;
int v5_stable      = false;
int v10_stable     = false;

/* Buffer to store the results of the ADC conversion */
volatile uint16_t adc_buffer[CHANNEL_COUNT];

void
dac_setvalue(uint32_t value)
{
#ifdef STM32F1
#ifdef USE_HAL_DRIVER
    /* Set DAC Channel 1 DHR12RD output value register */
    if (HAL_DAC_SetValue(&hdac, DAC_CHANNEL_1, DAC_ALIGN_12B_R,
                         value) != HAL_OK) {
        printf("Failed to set DAC value 0x%lx\n", value);
    }
#else
    /* Update the DAC channel1 12-bit right-aligned data holding register */
    dac_load_data_buffer_single(DAC1, value, DAC_ALIGN_RIGHT12, DAC_CHANNEL1);
#endif
#endif
}

static uint32_t
dac_getvalue(void)
{
#ifdef STM32F1
#ifdef USE_HAL_DRIVER
    return (HAL_DAC_GetValue(&hdac, DAC_CHANNEL_1));
#else
    return (DAC_DOR1(DAC1));
#endif
#else
    return (0);
#endif
}

#ifdef STM32F1
static void
dac_init(void)
{
#ifdef USE_HAL_DRIVER
    /* Initialize and Enable DAC Channel 1 */
    if (HAL_DAC_Start(&hdac, DAC_CHANNEL_1) != HAL_OK) {
        printf("DAC Start Error\n");
        return;
    }
#else
    /* Initialize and Enable DAC Channel 1 */
    rcc_periph_clock_enable(RCC_DAC);
    gpio_set_mode(GPIOA, GPIO_MODE_OUTPUT_50_MHZ,
                  GPIO_CNF_OUTPUT_ALTFN_PUSHPULL, GPIO4);
    dac_disable(DAC1, DAC_CHANNEL1);
    dac_enable(DAC1, DAC_CHANNEL1);
#endif

    dac_setvalue(0x2d0); // Approximately 10V
}
#endif


void
adc_init(void)
{
#ifdef USE_HAL_DRIVER
    /* ST-Micro HAL Library */
#ifdef STM32F4
    ADC_Common_TypeDef *adcbase = ADC_COMMON_REGISTER(&hadc1);

    /* Enable Vbat sensor */
    ADC_CCR(adcbase) |= ADC_CCR_VBATE;

    /* Enable Vtemperature sensor and Vrefint */
    ADC_CCR(adcbase) |= ADC_CCR_TSVREFE;
#else /* STM32F1 */
    ADC_Common_TypeDef *adcbase = ADC12_COMMON;

    /* Enable Vtemperature sensor and Vrefint */
    ADC_CR2(adcbase) |= ADC_CR2_TSVREFE;
#endif

    /* Enable DMA (ADCs previously set up by STM32CubeMX main.c */
    HAL_ADC_Start_DMA(&hadc1, (uint32_t *)adc_buffer, ARRAY_SIZE(adc_buffer));

#else
    /* libopencm3 */
    uint32_t adcbase = ADC1;
    size_t   p;

#ifdef STM32F4
    uint32_t dma     = DMA2;
    uint8_t  stream  = 4;  // STM32F4 UM Table: Summary of DMA2 requests...
    uint32_t channel = 0;

    for (p = 0; p < ARRAY_SIZE(channel_gpios); p++) {
        gpio_mode_setup(channel_gpios[p].gpio_port, GPIO_MODE_ANALOG,
                        GPIO_PUPD_NONE, channel_gpios[p].gpio_pin);
    }

    rcc_periph_clock_enable(RCC_ADC1);
    rcc_periph_clock_enable(RCC_DMA2);
    adc_power_off(adcbase); // Turn off ADC during configuration

    dma_disable_stream(dma, stream);
    dma_set_peripheral_address(dma, stream, (uintptr_t)&ADC_DR(adcbase));
    dma_set_memory_address(dma, stream, (uintptr_t)adc_buffer);
    dma_set_transfer_mode(dma, stream, DMA_SxCR_DIR_PERIPHERAL_TO_MEM);
    dma_set_number_of_data(dma, stream, CHANNEL_COUNT);
    dma_channel_select(dma, stream, channel);
    dma_disable_peripheral_increment_mode(dma, stream);
    dma_enable_memory_increment_mode(dma, stream);
    dma_set_peripheral_size(dma, stream, DMA_SxCR_PSIZE_16BIT);
    dma_set_memory_size(dma, stream, DMA_SxCR_MSIZE_16BIT);
    dma_enable_circular_mode(dma, stream);
    dma_set_priority(dma, stream, DMA_SxCR_PL_MEDIUM);
    dma_enable_direct_mode(dma, stream);
    dma_set_fifo_threshold(dma, stream, DMA_SxFCR_FTH_2_4_FULL);
    dma_set_memory_burst(dma, stream, DMA_SxCR_MBURST_SINGLE);
    dma_set_peripheral_burst(dma, stream, DMA_SxCR_PBURST_SINGLE);

    dma_enable_stream(dma, stream);

    adc_disable_dma(adcbase);

    adc_set_clk_prescale(ADC_CCR_ADCPRE_BY8);
    adc_set_multi_mode(ADC_CCR_MULTI_INDEPENDENT);

    adc_enable_scan_mode(adcbase);
    adc_set_continuous_conversion_mode(adcbase);
    adc_disable_external_trigger_regular(adcbase);
    adc_disable_external_trigger_injected(adcbase);
    adc_set_right_aligned(adcbase);

    adc_set_sample_time_on_all_channels(adcbase, ADC_SMPR_SMP_28CYC);
    adc_set_resolution(adcbase, ADC_CR1_RES_12BIT);

    /* Assign the channels to be monitored by this ADC */
    adc_set_regular_sequence(adcbase, CHANNEL_COUNT, (uint8_t *)channel_defs);

    adc_power_on(adcbase);
    timer_delay_usec(3); // Wait for ADC start up (3 us)

    /* Enable repeated DMA from ADC */
    adc_set_dma_continue(adcbase);
    adc_enable_dma(adcbase);
    adc_enable_temperature_sensor();
    adc_enable_vbat_sensor();
#else
    /* STM32F1... */
    uint32_t dma = DMA1;
    uint32_t channel = 1;  // STM32F1xx RM Table 78 Summary of DMA1 requests...

    for (p = 0; p < ARRAY_SIZE(channel_gpios); p++) {
        gpio_set_mode(channel_gpios[p].gpio_port, GPIO_MODE_INPUT,
                      GPIO_CNF_INPUT_ANALOG, channel_gpios[p].gpio_pin);
    }

    rcc_periph_clock_enable(RCC_ADC1);
    rcc_periph_clock_enable(RCC_DMA1);
    adc_power_off(adcbase);  // Turn off ADC during configuration
    rcc_periph_reset_pulse(RST_ADC1);
    adc_disable_dma(adcbase);

    dma_disable_channel(dma, channel);
    dma_channel_reset(dma, channel);
    dma_set_peripheral_address(dma, channel, (uintptr_t)&ADC_DR(adcbase));
    dma_set_memory_address(dma, channel, (uintptr_t)adc_buffer);
    dma_set_read_from_peripheral(dma, channel);
    dma_set_number_of_data(dma, channel, CHANNEL_COUNT);
    dma_disable_peripheral_increment_mode(dma, channel);
    dma_enable_memory_increment_mode(dma, channel);
    dma_set_peripheral_size(dma, channel, DMA_CCR_PSIZE_16BIT);
    dma_set_memory_size(dma, channel, DMA_CCR_MSIZE_16BIT);
    dma_enable_circular_mode(dma, channel);
    dma_set_priority(dma, channel, DMA_CCR_PL_MEDIUM);
    dma_enable_channel(dma, channel);

    adc_set_dual_mode(ADC_CR1_DUALMOD_IND);  // Independent ADCs

    adc_enable_scan_mode(adcbase);

    adc_set_continuous_conversion_mode(adcbase);
    adc_set_sample_time_on_all_channels(adcbase, ADC_SMPR_SMP_28DOT5CYC);
    adc_disable_external_trigger_regular(adcbase);
    adc_disable_external_trigger_injected(adcbase);
    adc_set_right_aligned(adcbase);
    adc_enable_external_trigger_regular(adcbase, ADC_CR2_EXTSEL_SWSTART);

    adc_set_regular_sequence(adcbase, CHANNEL_COUNT, (uint8_t *)channel_defs);
    adc_enable_temperature_sensor();

    adc_enable_dma(adcbase);

    adc_power_on(adcbase);
    adc_reset_calibration(adcbase);
    adc_calibrate(adcbase);
#endif

    /* Start the ADC and triggered DMA */
    adc_start_conversion_regular(adcbase);

#endif

#if defined(STM32F1)
    dac_init();
#endif
}

static void
print_reading(int value, char *suffix)
{
    int  units = value / 1000;
    uint milli = abs(value) % 1000;

    if (*suffix == 'C') {
        printf("%3d.%u %s", units, milli / 100, suffix);
    } else {
        printf("%2d.%02u %s", units, milli / 10, suffix);
    }
}

/*
 * adc_get_scale
 * -------------
 * Captures the current scale value from the sensor table.  This value is
 * based on the internal reference voltage and is then used to appropriately
 * scale all other ADC readings.
 */
static uint
adc_get_scale(uint16_t adc0_value)
{
    if (adc0_value == 0)
        adc0_value = 1;

    return (SCALE_VREF / adc0_value);
}

void
adc_show_sensors(void)
{
    uint     scale;
    uint16_t adc[CHANNEL_COUNT];
#if 0
    uint16_t raw;
    extern ADC_HandleTypeDef  hadc1;

    printf("VPP\n");
    HAL_ADC_Start(&hadc1);  // XXX: Only needs to be done once
    HAL_ADC_PollForConversion(&hadc1, HAL_MAX_DELAY);
    raw = HAL_ADC_GetValue(&hadc1);
    printf("rawV10SENSE = %u\n", raw);
#endif

    /*
     * raw / 4095 * 3V = voltage reading * resistor/div scale (8.5) = reading
     *      10K / 1.33K divider: 10V -> 1.174V (multiply reading by 8.51788756)
     *      So, if reading is 1614:
     *              1608 / 4096 * 3 = 1.177734375V
     *              1.177734375 * 8.51788756 = 10.0318
     *
     * PC4 ADC_U1 IN14 is V10SENSE (nominally 10V)
     *     ADC_U1 IN16 is STM32 Temperature (* 10000 / 25 - 279000)
     *     ADC_U1 IN17 is Vrefint 1.2V
     *     ADC_U1 IN18 is Vbat (* 2)
     *
     *     ADC_CHANNEL_TEMPSENSOR
     *     ADC_CHANNEL_VREFINT
     *     ADC_CHANNEL_VBAT
     *
     * We could use Vrefin_cal to get a more accurate expected Vrefint
     * from factory-calibrated values when Vdda was 3.3V.
     *
     * Temperature sensor formula
     *      Temp = (V25 - VSENSE) / Avg_Slope + 25
     *
     *           STM32F407               STM32F1xx
     *      V25  0.76V                   1.43V
     * AvgSlope  2.5                     4.3
     * Calc      * 10000 / 25 - 279000   * 10000 / 43 - 279000
     *
     * Channel order (STM32F4):
     *     adc_buffer[0] = Vrefint
     *     adc_buffer[1] = Vtemperature
     *     adc_buffer[2] = CH14 V10SENSE   (PC4)
     *     adc_buffer[3] =      V3P3SENSE  (Vbat) (STM32F4xx only)
     *     adc_buffer[4] = CH11 V5SENSE    (PC1) - not connected in Rev1
     *     adc_buffer[5] = CH15 V5CLSENSE  (PC5) - not connected in Rev1
     *     adc_buffer[6] = CH2  V10FBSENSE (PA2) - not connected in Rev1
     *
     * Channel order (STM32F1):
     *     adc_buffer[0] = Vrefint
     *     adc_buffer[1] = Vtemperature
     *     adc_buffer[2] =  CH3 V10SENSE   (PA3)
     *     adc_buffer[3] =  CH1 V3P3SENSE  (PA1) - not connected in Rev2
     *     adc_buffer[4] = CH14 V5SENSE    (PC4) - not connected in Rev2
     *     adc_buffer[5] = CH15 V5CLSENSE  (PC5) - not connected in Rev2
     *     adc_buffer[6] =  CH2 V10FBSENSE (PA2) - not connected in Rev2
     *
     * Algorithm:
     *  * Vrefint tells us what 1.21V (STM32F407) or 1.20V (STM32F1xx) should
     *  be according to ADCs.
     *  1. scale = 1.2 / adc_buffer[0]
     *          Because: reading * scale = 1.2V
     *  2. Report Vbat:
     *          adc_buffer[1] * scale * 2
     *  2. Report V10SENSE:
     *          adc_buffer[5] * scale * (30 / 3.45)
     *          adc_buffer[5] * scale * 3000 / 345
     *
     * TODO:
     *    Function to compute current sensor values
     *       - including current for V5CL once sensors are implemented
     * Compute current flow with diff of V5CL vs V5?
     *
     * Add test to MX code for overcurrent
     *     1) Check V5CL current with VPP / VCC off
     *     2) Check with VCC on
     *     3) Check with VPP on
     *     4) Check with both on
     */
    memcpy(adc, (void *)adc_buffer, sizeof (adc));
    scale = adc_get_scale(adc[0]);

    uint calc_temp;
    uint calc_v10;
    uint calc_v5;
    uint calc_v3p3;
    uint calc_v5cl;
    uint calc_v5cl_ma;
    uint calc_v10fb;
    calc_temp = ((int)(TEMP_V25 * 10000 - adc[1] * scale)) / TEMP_AVGSLOPE +
                TEMP_BASE;
    calc_v10   = adc[2] * scale * V10_DIVIDER_SCALE;
    calc_v3p3  = adc[3] * scale * V3P3_DIVIDER_SCALE;
    calc_v5    = adc[4] * scale * V5_DIVIDER_SCALE;
    calc_v5cl  = adc[5] * scale * V5CL_DIVIDER_SCALE;
    calc_v10fb = adc[6] * scale / 10000;
    if (calc_v5 > calc_v5cl) {
        /* I=V/R  Current limit resistor is 22 Ohms on Rev2 / Rev3 */
        calc_v5cl_ma = (calc_v5 - calc_v5cl) * 1000 / 22;
    } else {
        calc_v5cl_ma = 0;
    }
#ifdef STM32F1
    printf("    DAC=%04lx\n", dac_getvalue());
#endif
    printf("Vrefint=%04x scale=%d\n", adc[0], scale);
    printf("  Vtemp=%04x %8u ", adc[1], adc[1] * scale);
    print_reading(calc_temp, "C\n");
    printf("    V10=%04x %8u ", adc[2], adc[2] * scale);
    print_reading(calc_v10, "V");
    printf("  EEPROM VPP=%s\n", prom_vpp_is_on() ? "On" : "Off");
    printf("   V3P3=%04x %8u ", adc[3], adc[3] * scale);
    print_reading(calc_v3p3, "V\n");
    printf("     V5=%04x %8u ", adc[4], adc[4] * scale);
    print_reading(calc_v5, "V");
    printf("  EEPROM VCC=%s\n", prom_vcc_is_on() ? "On" : "Off");
    printf("   V5CL=%04x %8u ", adc[5], adc[5] * scale);
    print_reading(calc_v5cl, "V  ");
    print_reading(calc_v5cl_ma, "mA\n");
    printf("  V10FB=%04x %8u ", adc[6], adc[6] * scale);
    print_reading(calc_v10fb, "V\n");
}

/*
 * adc_poll() will capture the current readings from the sensors and take
 *            action to maintain the 10V rail as close as possible to 10V.
 */
void
adc_poll(int verbose, int force)
{
    uint16_t        adc[CHANNEL_COUNT];
    uint            scale;        // Current scale from internal ref voltage
    uint            calc_v5;      // Scaled V5 reading from the ADC
    uint            calc_v5cl;    // Scaled V5CL reading from the ADC
    uint            calc_v5cl_ma; // Scaled V5CL reading from the ADC
    uint            calc_v10;     // Scaled V10 reading from the ADC
#ifdef STM32F107
    int             percent5;     // 0.1 percent voltage deviation for 5V
#endif
    int             diff;         // Difference from expected in millivolts
    int             percent10;    // 0.1 percent voltage deviation for 10V
    static uint64_t next_check = 0;

    if ((timer_tick_has_elapsed(next_check) == false) && (force == false))
        return;
    next_check = timer_tick_plus_msec(1);  // Limit rate to prevent overshoot

    memcpy(adc, (void *)adc_buffer, sizeof (adc));
    scale = adc_get_scale(adc[0]);

    calc_v10  = adc[2] * scale * V10_DIVIDER_SCALE;
    calc_v5   = adc[4] * scale * V5_DIVIDER_SCALE;
    calc_v5cl = adc[5] * scale * V5CL_DIVIDER_SCALE;
    diff = V10_EXPECTED_MV - calc_v10;
    percent10 = diff * 1000 / V10_EXPECTED_MV;
    if ((percent10 > 5) || (percent10 < -5)) {
        uint32_t dac_old = dac_getvalue();
        uint32_t dac_new;
        if (percent10 > 0)
            dac_new = dac_old - 1;
        else
            dac_new = dac_old + 1;
#undef DEBUG_AUTO_V10
#ifdef DEBUG_AUTO_V10
        printf("V10=");
        print_reading(calc_v10, "V");
        printf(" %d %d.%d%% %lx -> %lx\n",
               diff, percent10 / 10, abs(percent10) % 10, dac_old, dac_new);
#endif
        if ((dac_new >= 0x290) && (dac_new <= 0x2ff)) {
#undef DEBUG_AUTO_V10_SIMPLE
#ifdef DEBUG_AUTO_V10_SIMPLE
            if (percent10 < 0)
                printf("+");
            else
                printf("-");
#endif
            dac_setvalue(dac_new);
        }

        if ((percent10 > 50) || (percent10 < -50)) {
            /* Off by greater than 5% means we should not allow programming */
            if ((v10_stable == true) && verbose) {
                printf("V10 not stable at ");
                print_reading(calc_v10, "V\n");
            }
            v10_stable = false;
        } else {
            if ((v10_stable == false) && verbose) {
                printf("V10 stable at ");
                print_reading(calc_v10, "V\n");
            }
            v10_stable = true;
        }
    }
#ifdef STM32F107
    diff = V5_EXPECTED_MV - calc_v5cl;
    percent5 = diff * 1000 / V5_EXPECTED_MV;
    if ((percent5 > 100) || (percent5 < -100)) {
        /* Off by greater than 10% means we should not allow programming */
        if ((v5_stable == true) && verbose) {
            printf("V5 not stable at ");
            print_reading(calc_v5cl, "V\n");
        }
        v5_stable = false;
    } else {
        if ((v5_stable == false) && verbose) {
            printf("V5 stable at ");
            print_reading(calc_v5cl, "V\n");
        }
        v5_stable = true;
    }

    if (calc_v5 > calc_v5cl) {
        /* I=V/R  Current limit resistor is 22 Ohms on Rev2 / Rev3 */
        calc_v5cl_ma = (calc_v5 - calc_v5cl) * 1000 / 22;
    } else {
        calc_v5cl_ma = 0;
    }
    if (calc_v5cl_ma < 20000) {
        if ((v5_overcurrent == true) && verbose) {
            printf("V5 current normal at ");
            print_reading(calc_v5cl_ma, "mA\n");
        }
        v5_overcurrent = false;
    } else {
        if ((v5_overcurrent == false) && verbose) {
            printf("V5 overcurrent at ");
            print_reading(calc_v5cl_ma, "mA\n");
        }
        v5_overcurrent = true;
    }
#else
    (void) calc_v5;
    (void) calc_v5cl;
    (void) calc_v5cl_ma;
    v5_stable = true;
#endif
}
