cdhooper/mx29f1615_programmer/(commit log)

2021-04-21 First commit for public repository: rev4, stable sw, stable fw using libopencm3
    [BOM_MX29F1615 Programmer rev4_2021-03-23.csv, BOM_PCB for case_2021-03-23.csv, PickAndPlace_PCB for case_2021-03-23.csv]
2021-05-23 Add rev5 board
    [BOM_PCB for case_2021-05-16.csv, PickAndPlace_PCB for case_2021-05-16.csv]
2021-06-17 mxprog -e -w -v may now be specified in one command Added "usb" command to firmware Added USB VBus missing detection for F105 and F107 Added temperature calculation fix from Stefan Reinauer Added com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
    [adc.c, button.c, cmdline.c, gpio.c, irq.c, led.c, main.c, mx29f1615.c]
2022-02-04 Rev 1.3
    Added "gpio" command to display / set GPIO configuration
    Added "rand" pattern to "patt" and "test" commands
    Added board rev 5 errata
    Added board rev 6 production files
    [BOM_PCB for case_2021-07-19.csv, PickAndPlace_PCB for case_2021-07-19.csv]
2022-12-07 Minor function doc improvements Increased maximum command line length to 600 bytes Fixed input buffer overrun bug
    [adc.c, cmdline.c, gpio.c, usb.c]
2023-02-18 Added help text for gpio command Minor fix for map command Added missing Rev6 Gerbers
    [gpio.c, pcmds.c]
2025-03-16 Firmware - Improved gpio command to allow using net names to reference pins - The "prom id" command now identifies the installed chip, if known - Added DMA2, FPEC, TIM5, and TIM6 to "map" command out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
    [cmdline.c, cmds.c, gpio.c, gpio.h, main.c, mx29f1615.c, mx29f1615.h]
2025-03-17 Fix introduced bug in binary prom write
    [mx29f1615.c]
2025-09-02 Back-ported "addr" option for "patt" command from other firmware Back-ported enhanced and fixed "test" command from other firmware
    [cmdline.c, cmds.c]
2025-12-16 Sync MED command line fixes and enhancements across repositories
    [cmdline.c, cmds.c, gpio.c]
2026-04-10 Update support for STM32F407
